JoshW428/SummerResearch/README.md

# SummerResearch
Research on Parkinsons Device
